MatthewLaverty/neon-digital-gauges/docs/neon-gauge-measurements.jpg

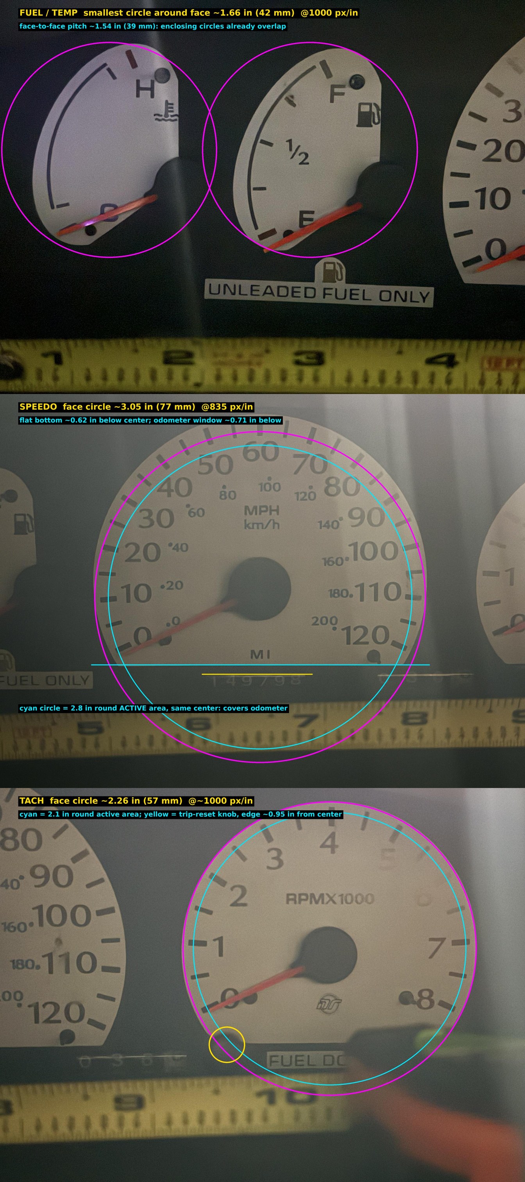
docs/neon-gauge-measurements.jpg
