MatthewLaverty/neon-digital-gauges/docs/frame/ref_frame_IMG_7629.jpg

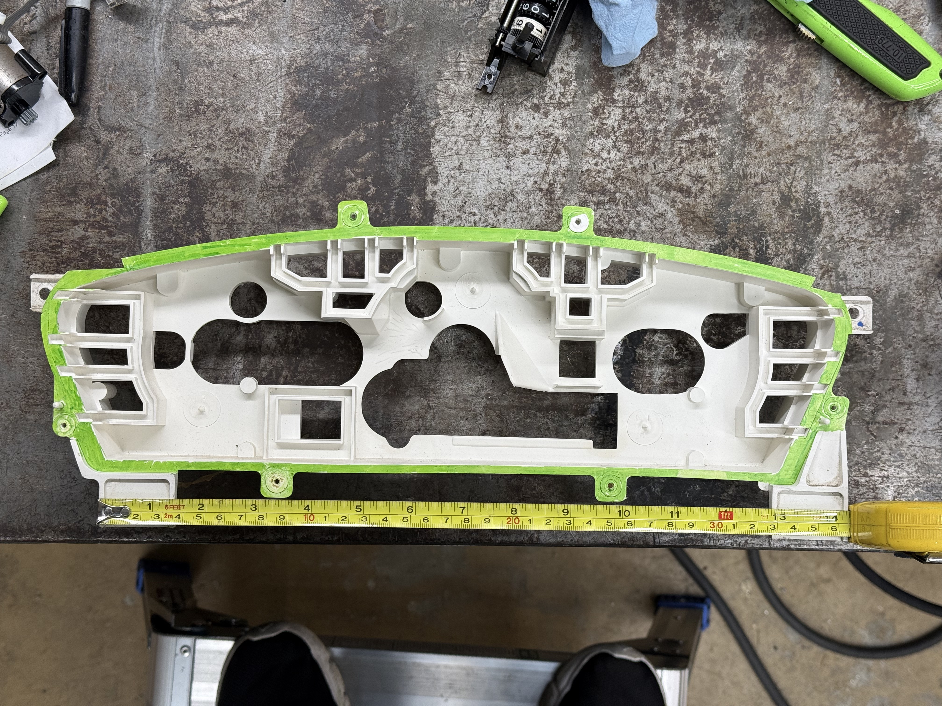
docs/frame/ref_frame_IMG_7629.jpg
