MatthewLaverty/neon-digital-gauges/docs/TOOLCHAIN.md

# Toolchain (pin these, update deliberately)
| Item | Version | Notes |
|---|---|---|
| Arduino IDE | record here | |
| esp32 Arduino core | match Waveshare demo | record exact version used by the demo you fork |
| LVGL | 8.3.10 | Waveshare examples target 8.3.10; do NOT use v9 with their BSP |
| Board settings | ESP32S3 Dev Module, PSRAM OPI, 16MB flash, USB CDC on boot | confirm per Waveshare wiki |
