MatthewLaverty/neon-digital-gauges/art/boost/boost_dial_A8_R240.png

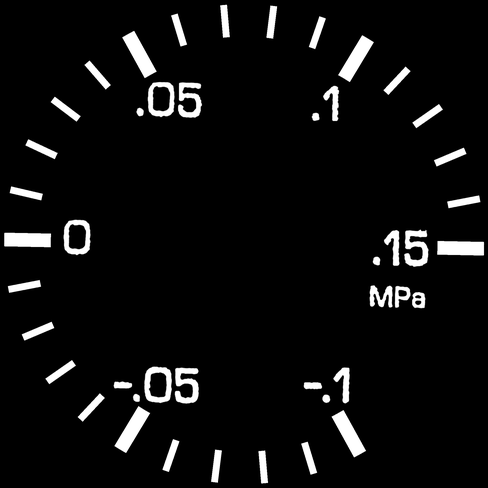
art/boost/boost_dial_A8_R240.png
