MatthewLaverty/neon-digital-gauges/art/boost/ref_IMG_7566.jpg

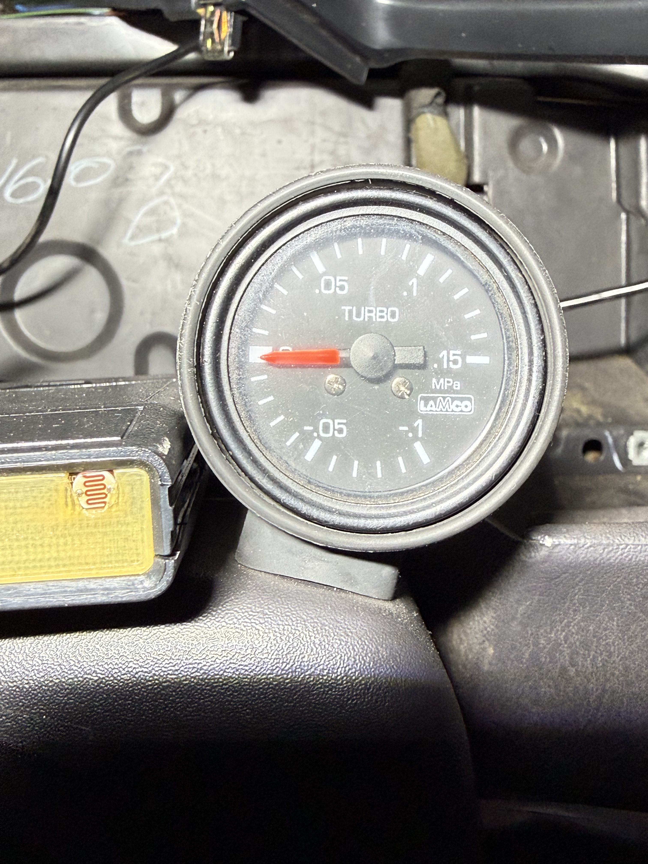
art/boost/ref_IMG_7566.jpg
