MatthewLaverty/neon-digital-gauges/art/faces/cluster_master_10pxmm.png

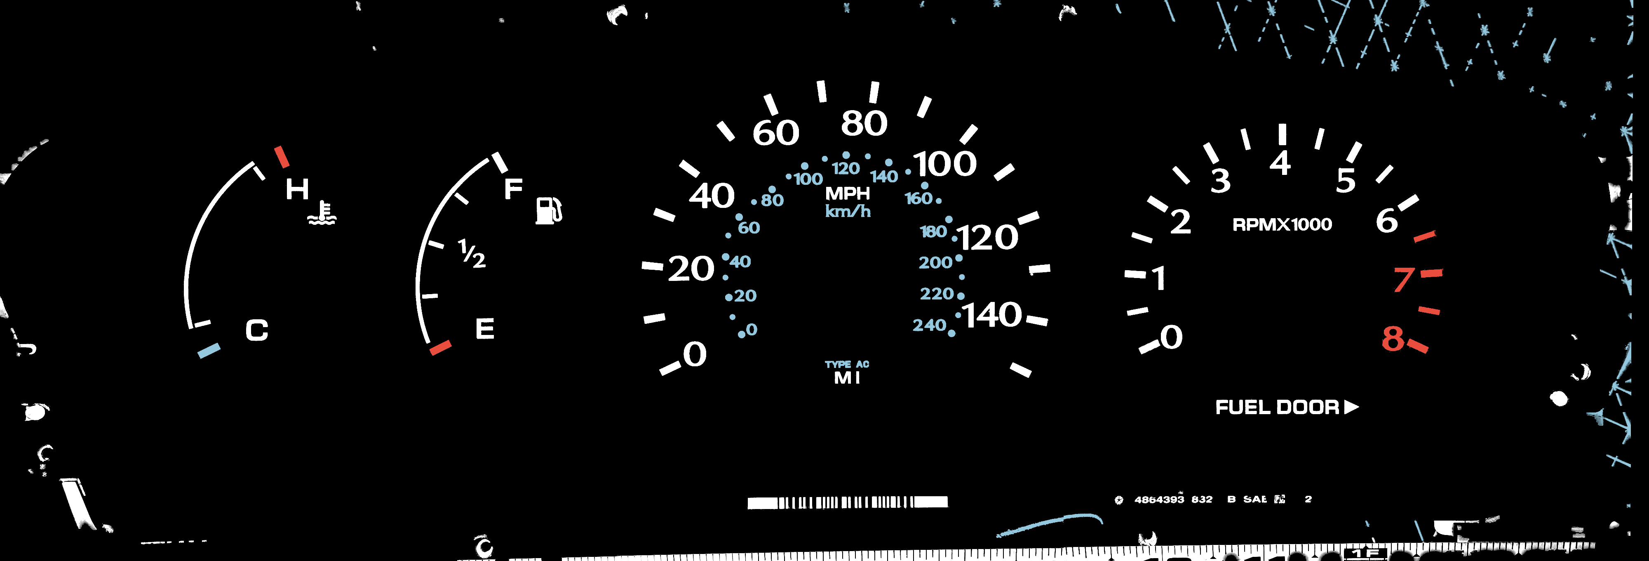
art/faces/cluster_master_10pxmm.png
