MatthewLaverty/neon-digital-gauges/art/faces/fuel_480.png

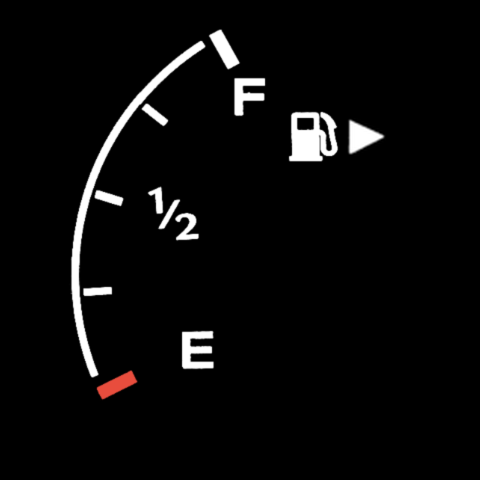
art/faces/fuel_480.png
