MatthewLaverty/neon-digital-gauges/art/faces/source/tach_480_with_fuel_door.png

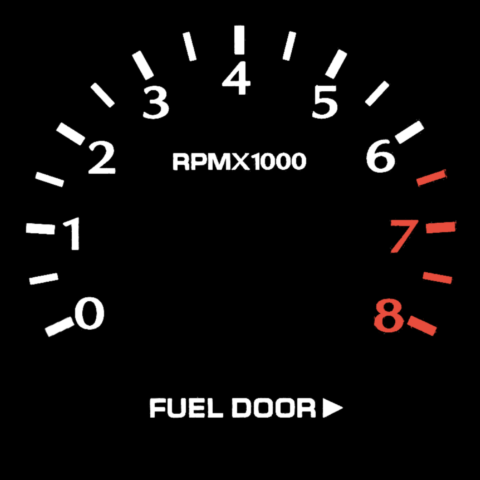
art/faces/source/tach_480_with_fuel_door.png
