MatthewLaverty/neon-digital-gauges/art/faces/speedo_480.png

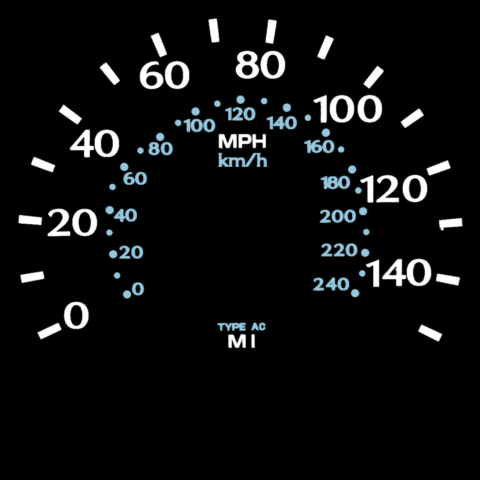
art/faces/speedo_480.png
