MatthewLaverty/neon-digital-gauges/art/glyphs/iso7000-2426_oil_temp_hires.png

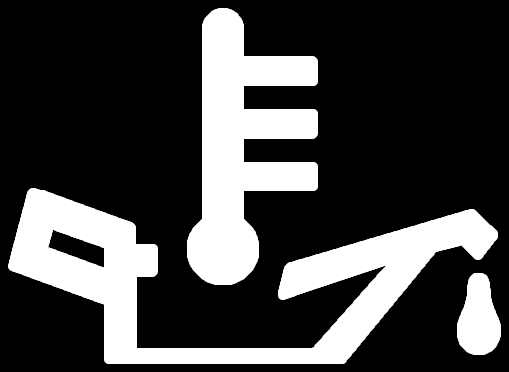
art/glyphs/iso7000-2426_oil_temp_hires.png
