MatthewLaverty/neon-digital-gauges/art/glyphs/seg7/ref_dakota_cluster.webp

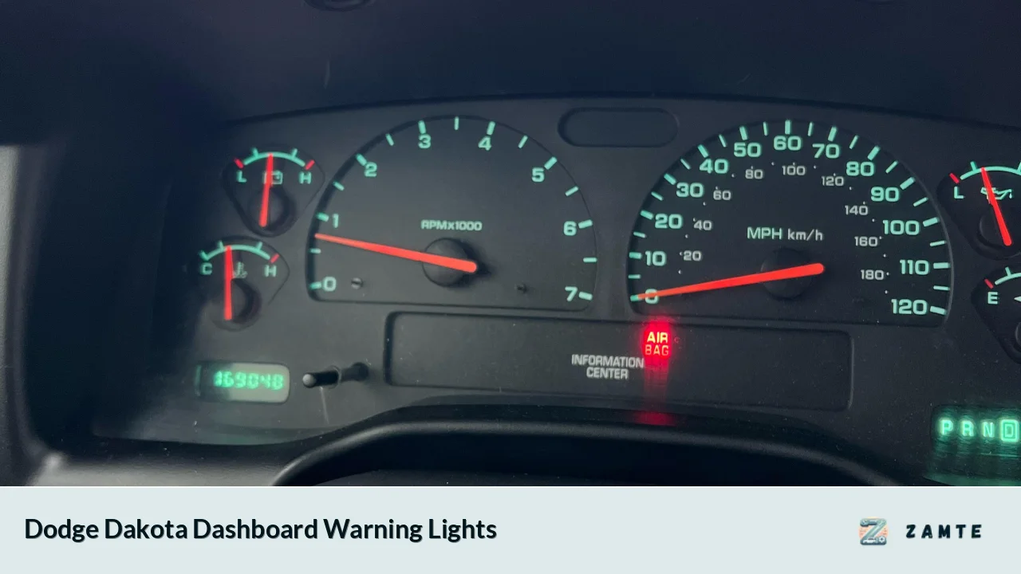
art/glyphs/seg7/ref_dakota_cluster.webp
