MatthewLaverty/neon-digital-gauges/art/glyphs/seg7/ref_toyota_odo.jpg

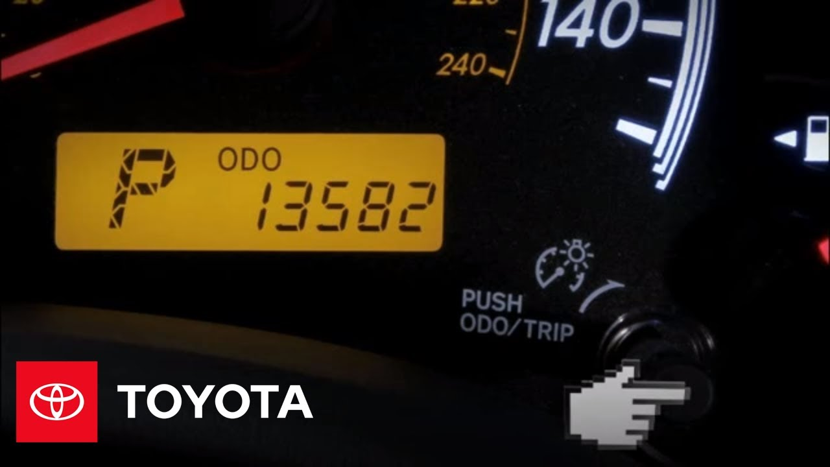
art/glyphs/seg7/ref_toyota_odo.jpg
