MatthewLaverty/neon-digital-gauges/art/glyphs/seg7/ref_toyota_ODO_trace.png

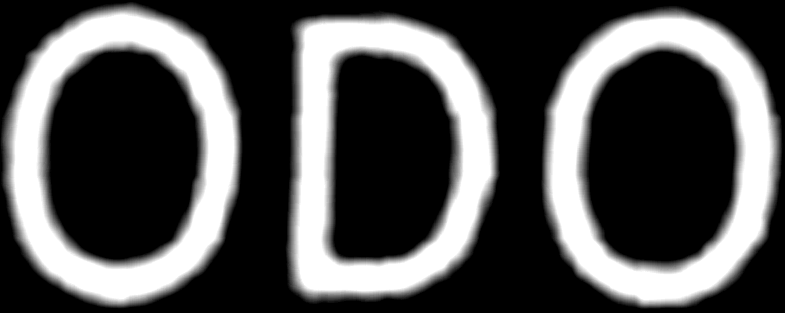
art/glyphs/seg7/ref_toyota_ODO_trace.png
