MatthewLaverty/neon-digital-gauges/art/glyphs/seg7/ref_toyota_trip.jpg

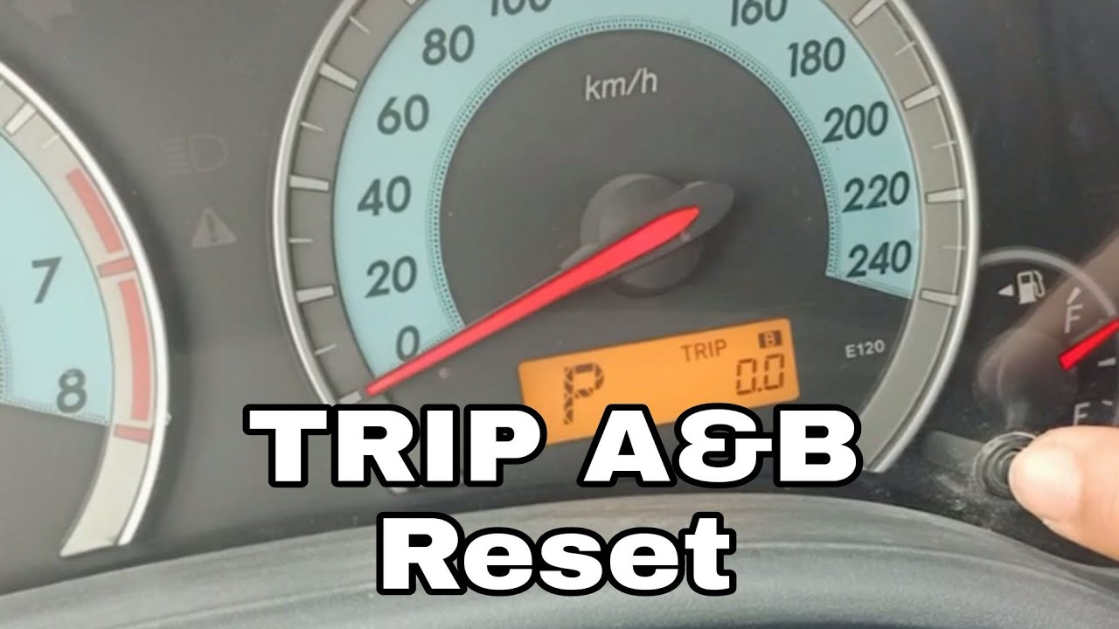
art/glyphs/seg7/ref_toyota_trip.jpg
