MatthewLaverty/neon-digital-gauges/art/preview/alert_flash_preview.png

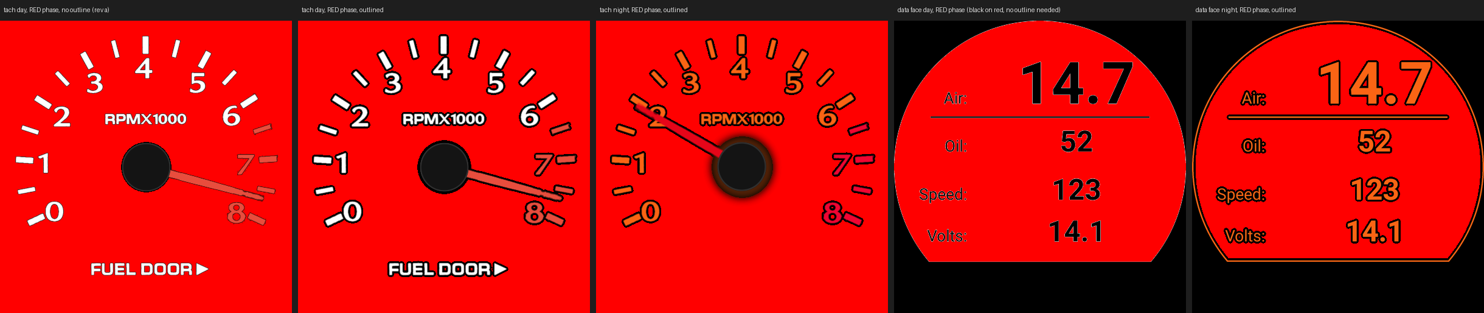
art/preview/alert_flash_preview.png
