MatthewLaverty/neon-digital-gauges/art/preview/all_holecheck.png

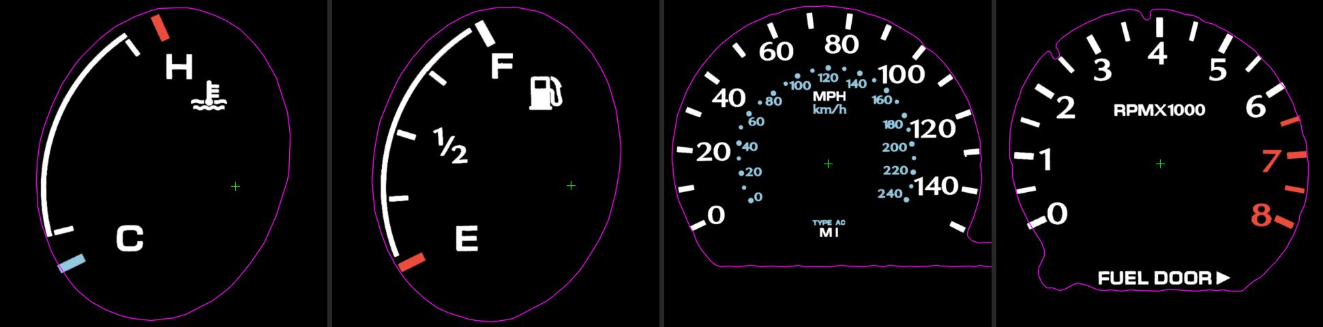
art/preview/all_holecheck.png
