MatthewLaverty/neon-digital-gauges/art/preview/all_with_needles.png

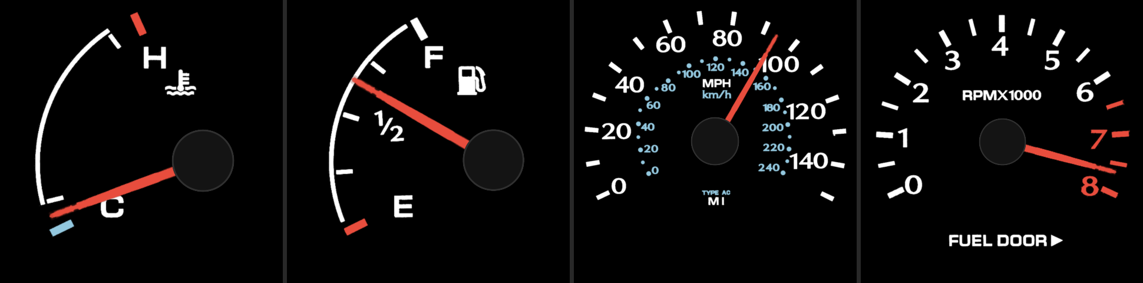
art/preview/all_with_needles.png
