MatthewLaverty/neon-digital-gauges/art/preview/cluster_mockup.png

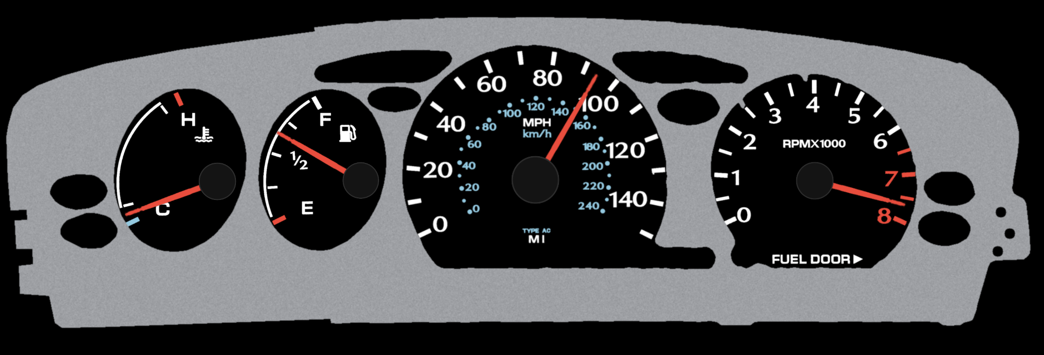
art/preview/cluster_mockup.png
