MatthewLaverty/neon-digital-gauges/art/preview/fuel_480_holecheck.png

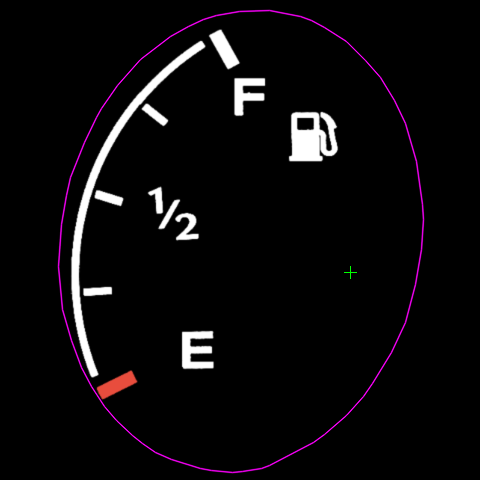
art/preview/fuel_480_holecheck.png
