MatthewLaverty/neon-digital-gauges/art/preview/fuel_480_night.png

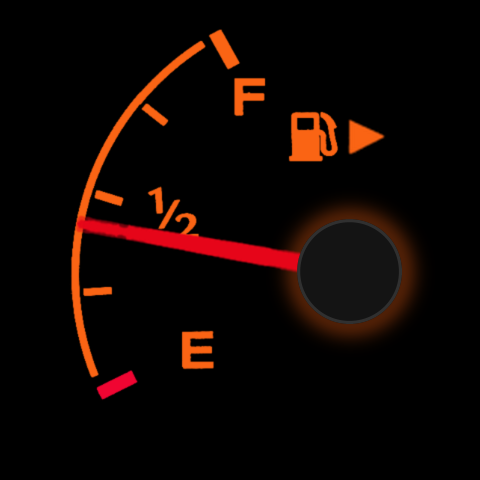
art/preview/fuel_480_night.png
