MatthewLaverty/neon-digital-gauges/art/preview/fuel_480_with_needle.png

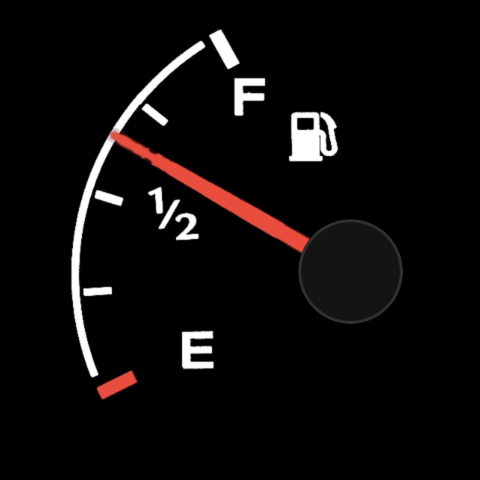
art/preview/fuel_480_with_needle.png
