MatthewLaverty/neon-digital-gauges/art/preview/fuel_cel_preview.png

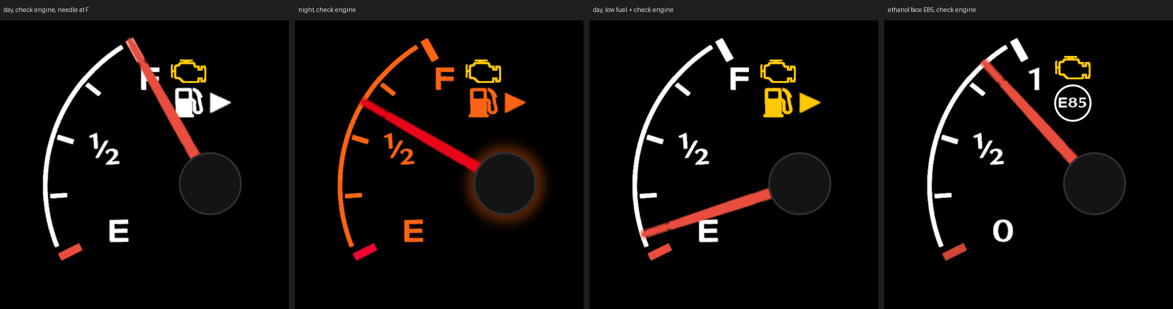
art/preview/fuel_cel_preview.png
