MatthewLaverty/neon-digital-gauges/art/preview/fuel_ethanol_preview.png

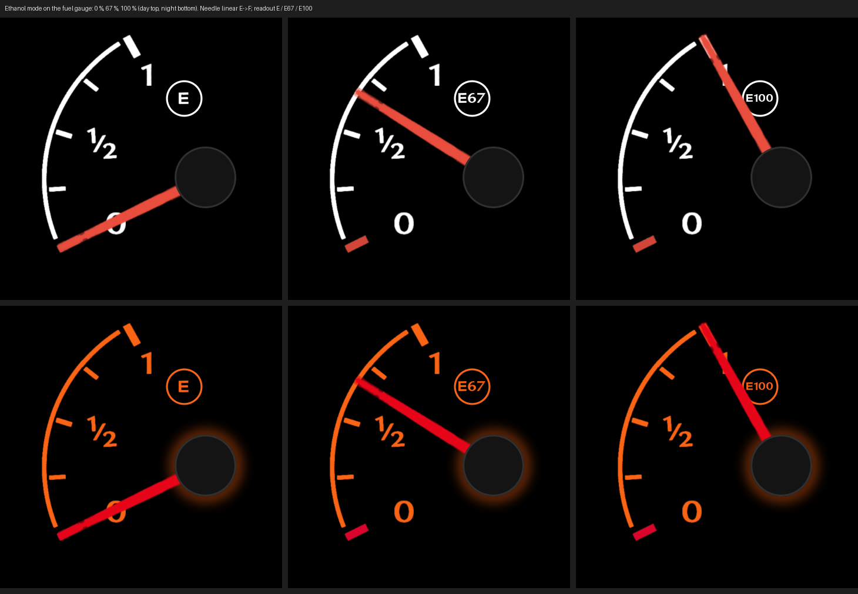
art/preview/fuel_ethanol_preview.png
