MatthewLaverty/neon-digital-gauges/art/preview/fuel_lowfuel_preview.png

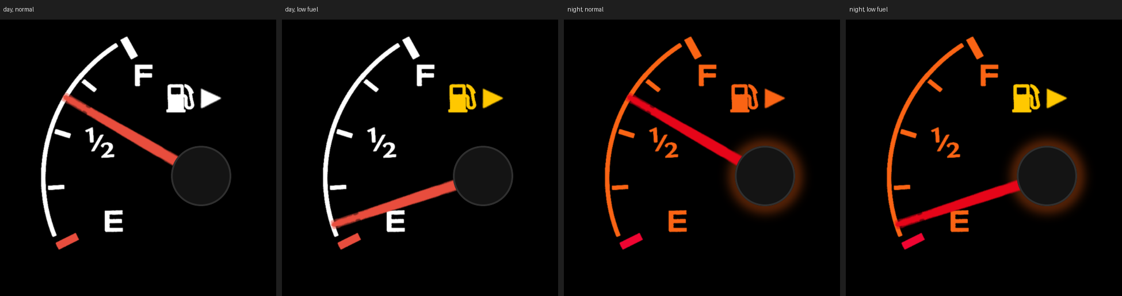
art/preview/fuel_lowfuel_preview.png
