MatthewLaverty/neon-digital-gauges/art/preview/knob_ui_preview.png

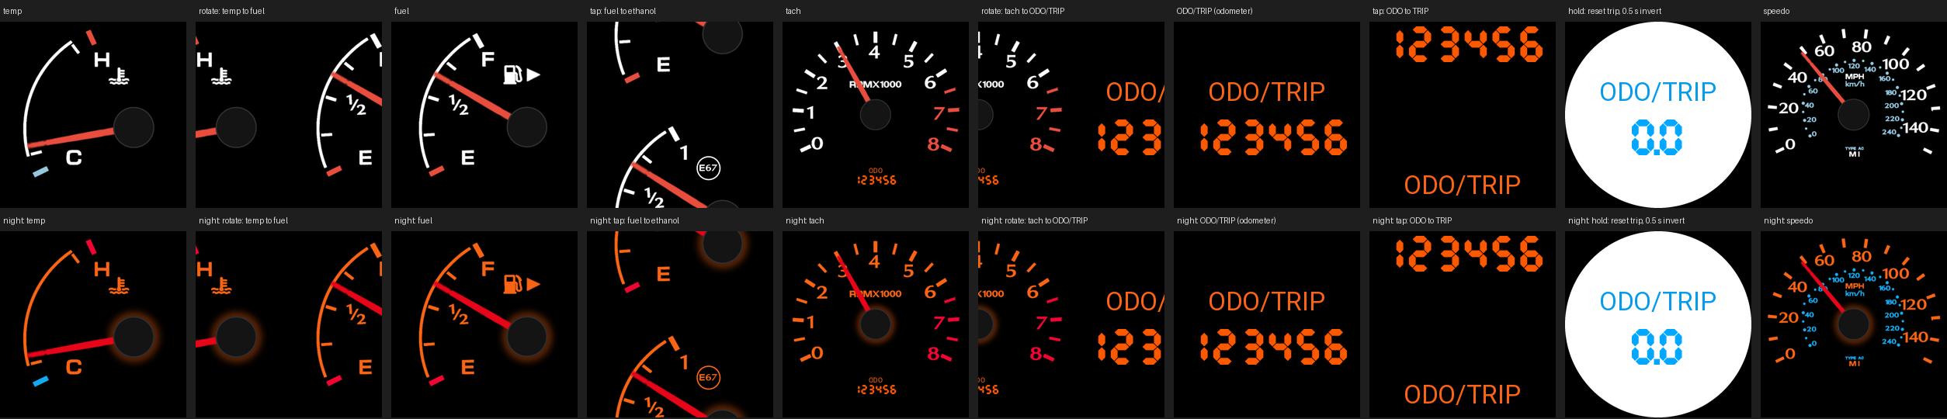
art/preview/knob_ui_preview.png
