MatthewLaverty/neon-digital-gauges/art/preview/night_mode_preview.png

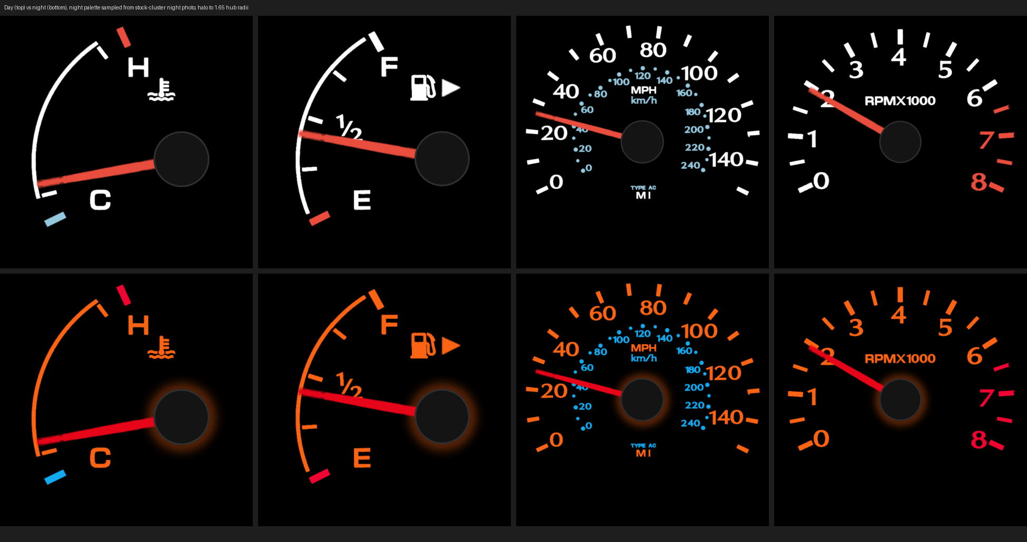
art/preview/night_mode_preview.png
