MatthewLaverty/neon-digital-gauges/art/preview/odo_trip_preview.png

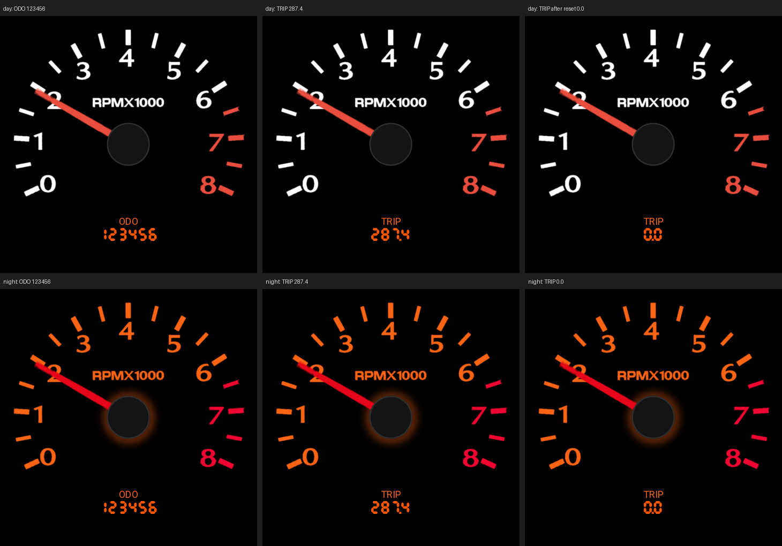
art/preview/odo_trip_preview.png
