MatthewLaverty/neon-digital-gauges/art/preview/odo_zoom.png

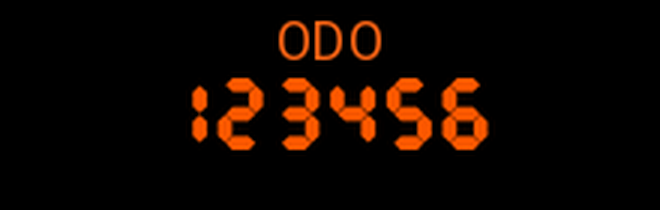
art/preview/odo_zoom.png
