MatthewLaverty/neon-digital-gauges/art/preview/speedo_480_holecheck.png

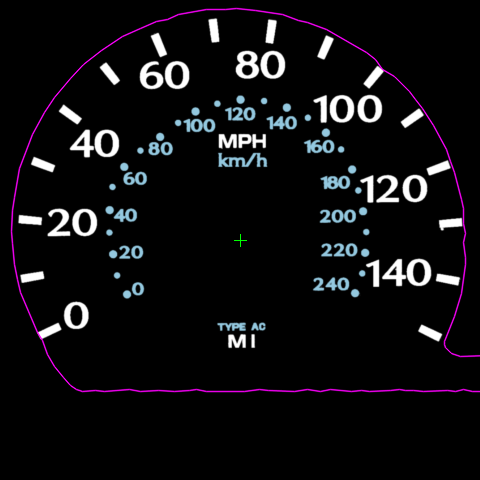
art/preview/speedo_480_holecheck.png
