MatthewLaverty/neon-digital-gauges/art/preview/speedo_480_night.png

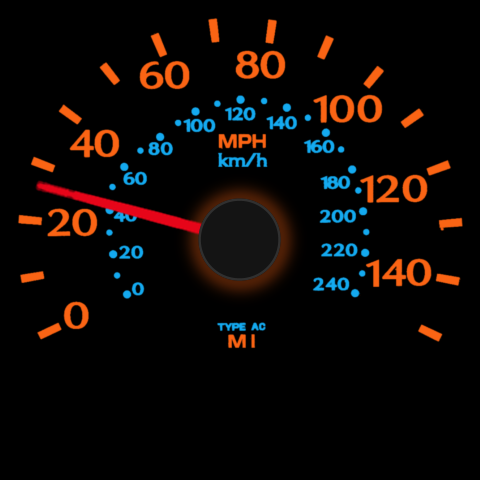
art/preview/speedo_480_night.png
