MatthewLaverty/neon-digital-gauges/art/preview/speedo_data_800_day.png

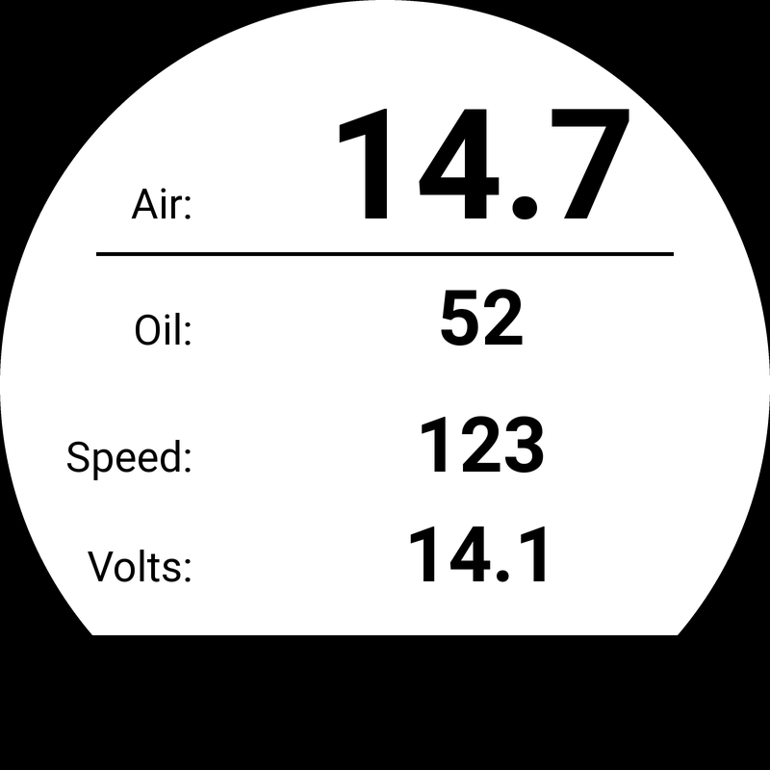
art/preview/speedo_data_800_day.png
