MatthewLaverty/neon-digital-gauges/art/preview/speedo_data_800_night.png

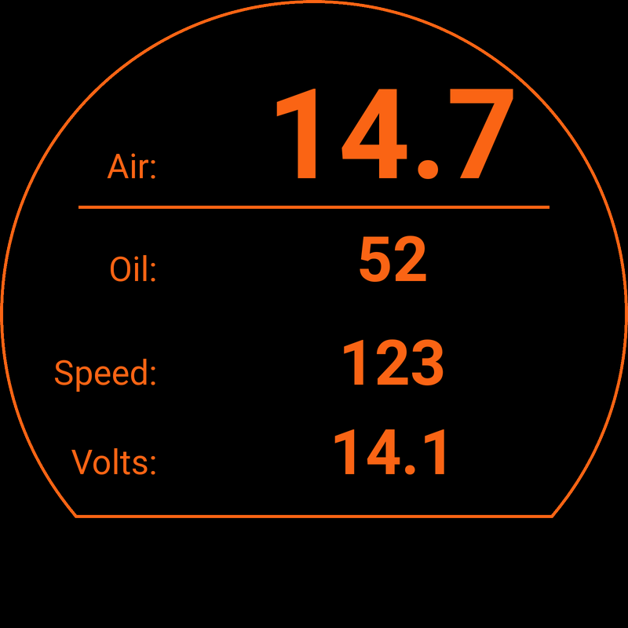
art/preview/speedo_data_800_night.png
