MatthewLaverty/neon-digital-gauges/art/preview/speedo_data_preview.png

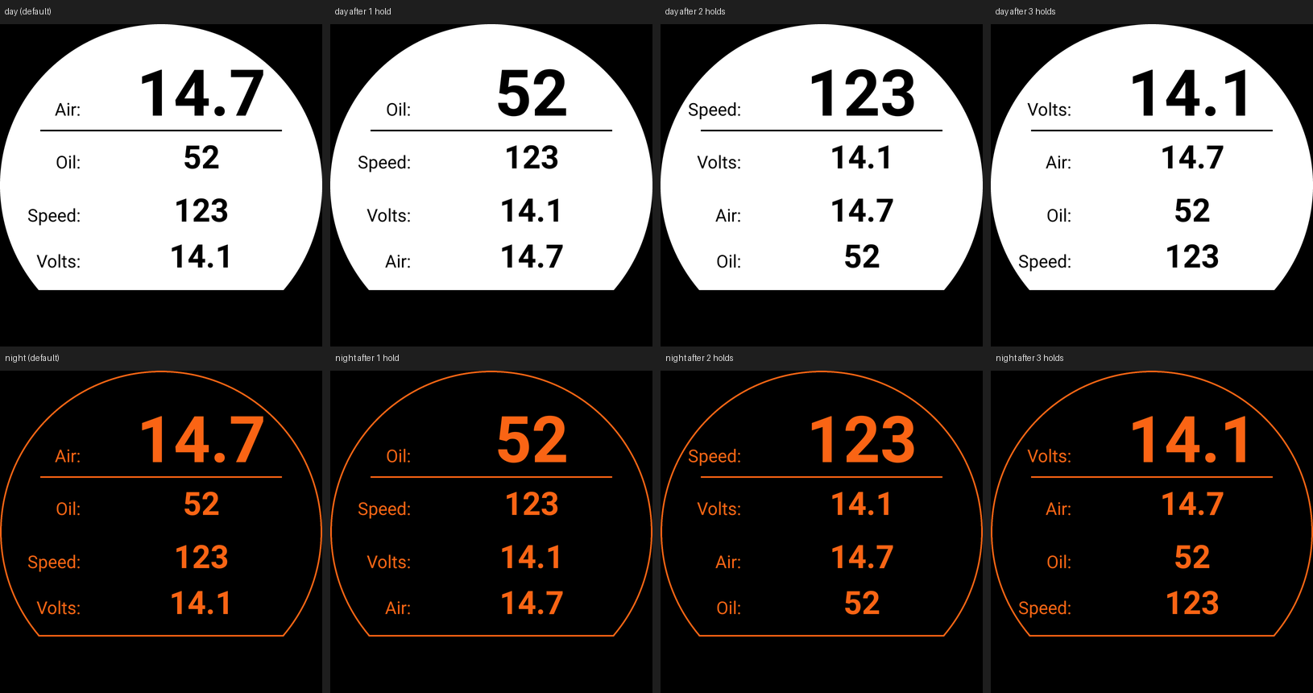
art/preview/speedo_data_preview.png
