MatthewLaverty/neon-digital-gauges/art/preview/tach_480_holecheck.png

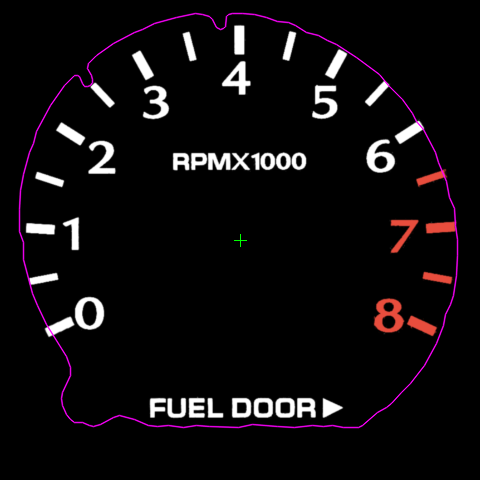
art/preview/tach_480_holecheck.png
