MatthewLaverty/neon-digital-gauges/art/preview/tach_480_night.png

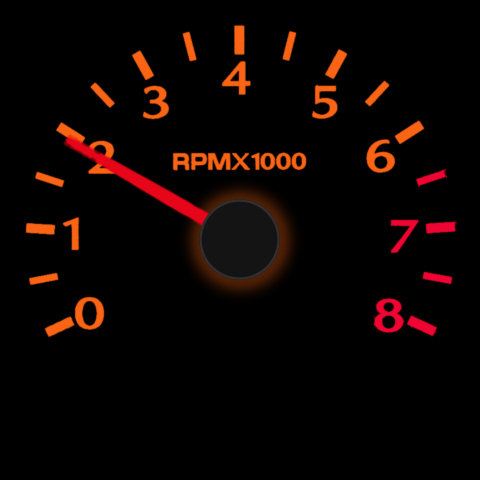
art/preview/tach_480_night.png
