MatthewLaverty/neon-digital-gauges/art/preview/tach_480_with_needle.png

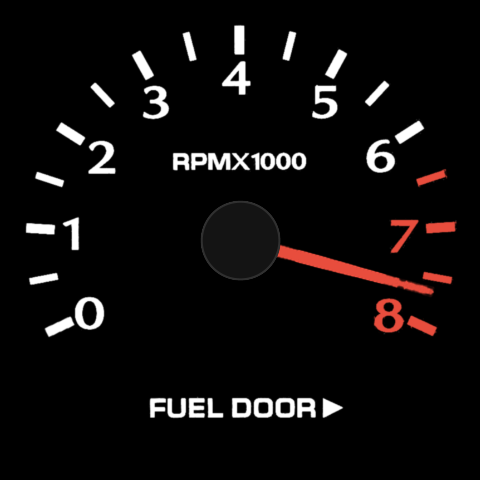
art/preview/tach_480_with_needle.png
