MatthewLaverty/neon-digital-gauges/art/preview/tach_boost_480.png

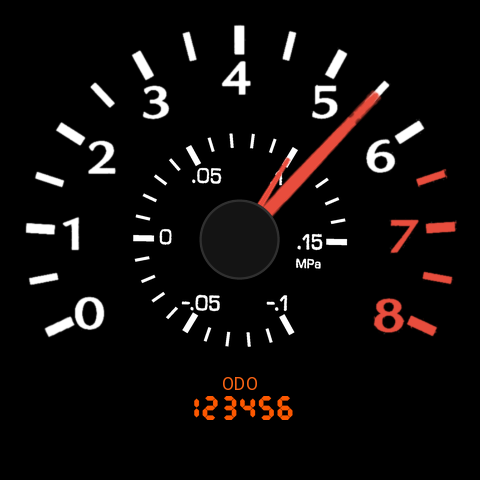
art/preview/tach_boost_480.png
