MatthewLaverty/neon-digital-gauges/art/preview/tach_boost_480_night.png

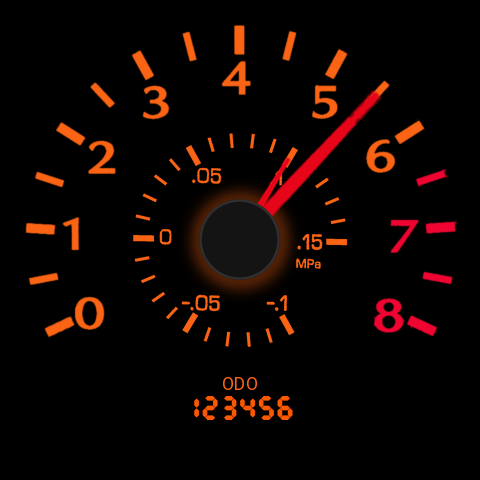
art/preview/tach_boost_480_night.png
