MatthewLaverty/neon-digital-gauges/art/preview/tach_boost_preview.png

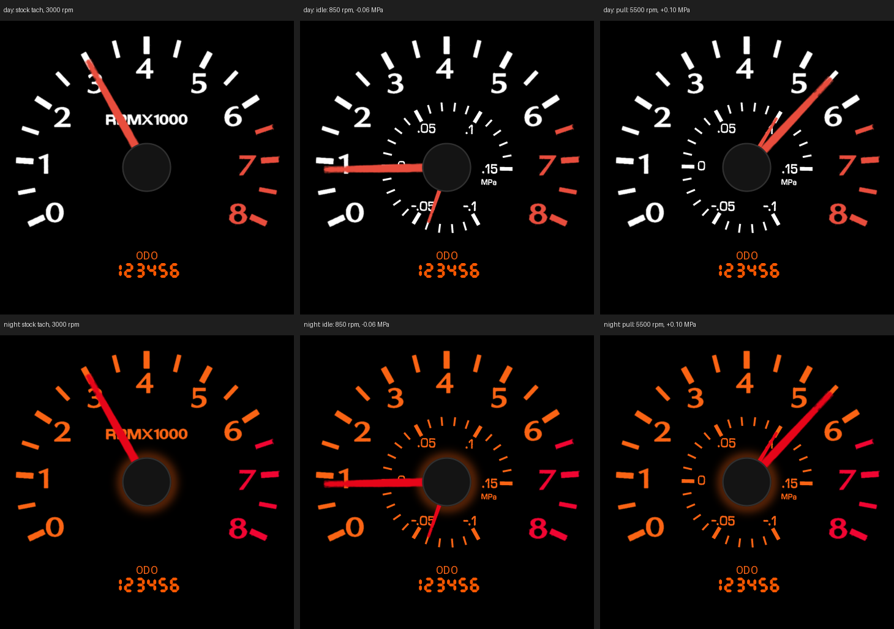
art/preview/tach_boost_preview.png
