MatthewLaverty/neon-digital-gauges/art/preview/temp_480_with_needle.png

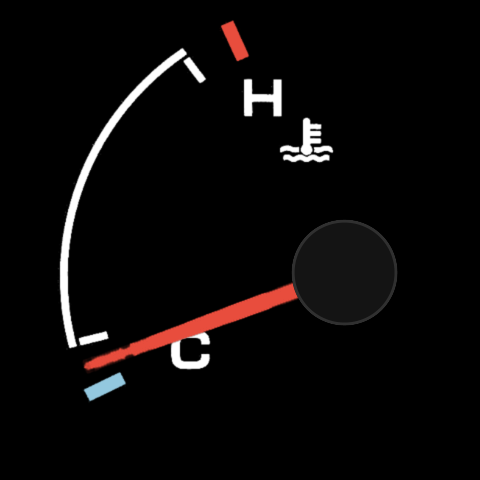
art/preview/temp_480_with_needle.png
