MatthewLaverty/neon-digital-gauges/art/preview/temp_oil_preview.png

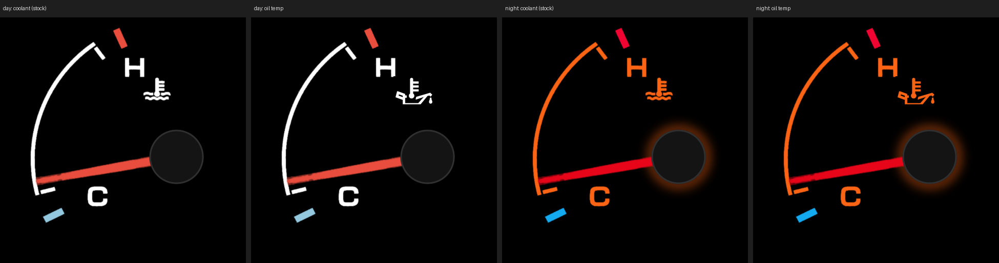
art/preview/temp_oil_preview.png
