MatthewLaverty/neon-digital-gauges/docs/bench/breadboard_car_io.png

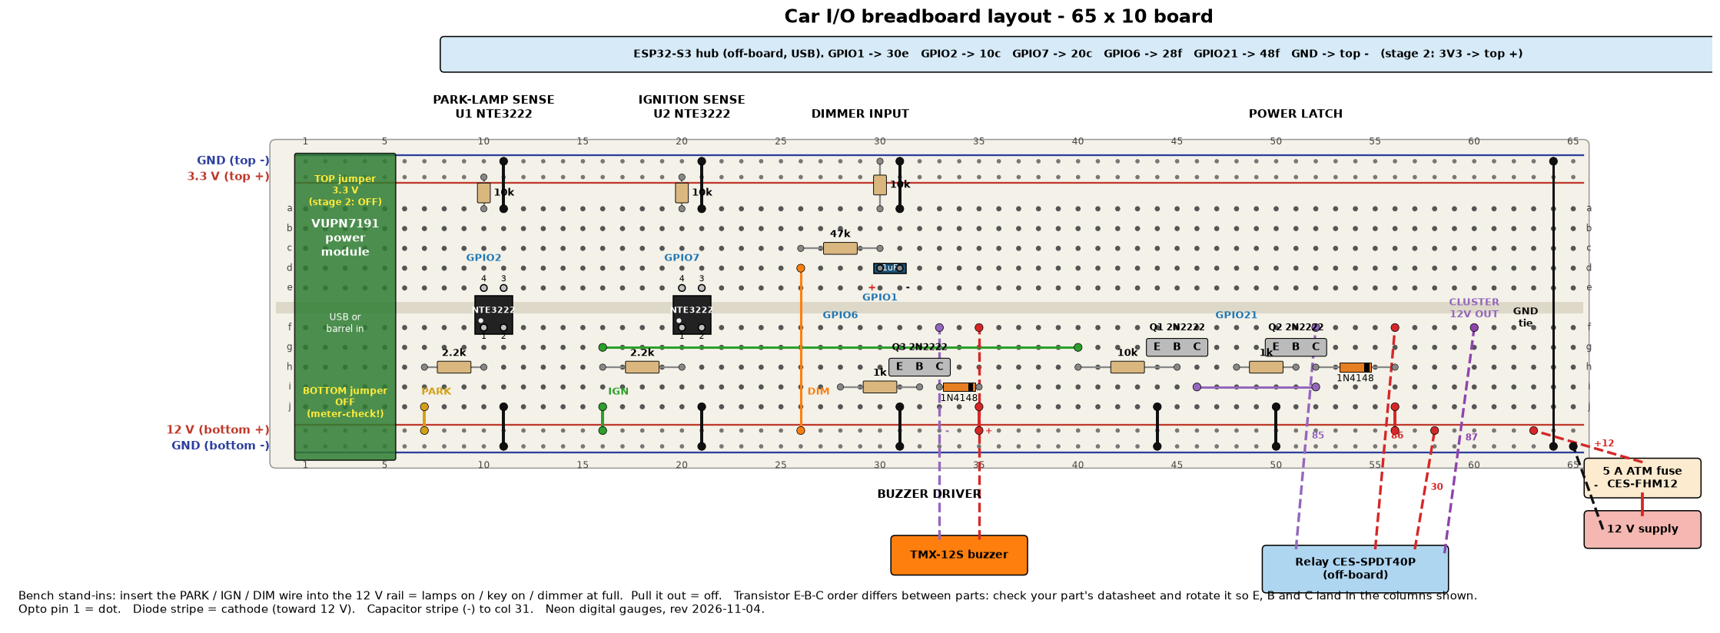
docs/bench/breadboard_car_io.png
