MatthewLaverty/neon-digital-gauges/docs/frame/frame_fit.png

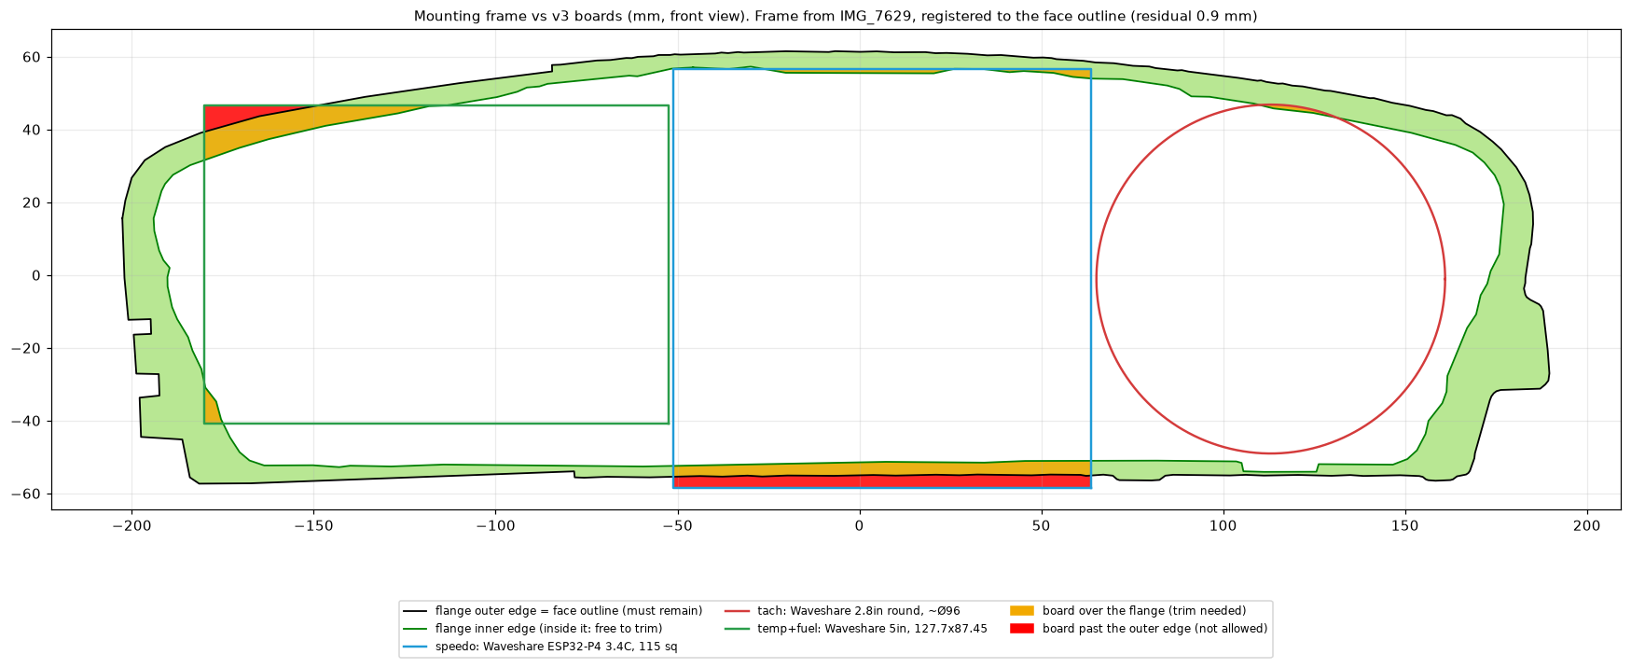
docs/frame/frame_fit.png
