MatthewLaverty/neon-digital-gauges/docs/frame/frame_trim.png

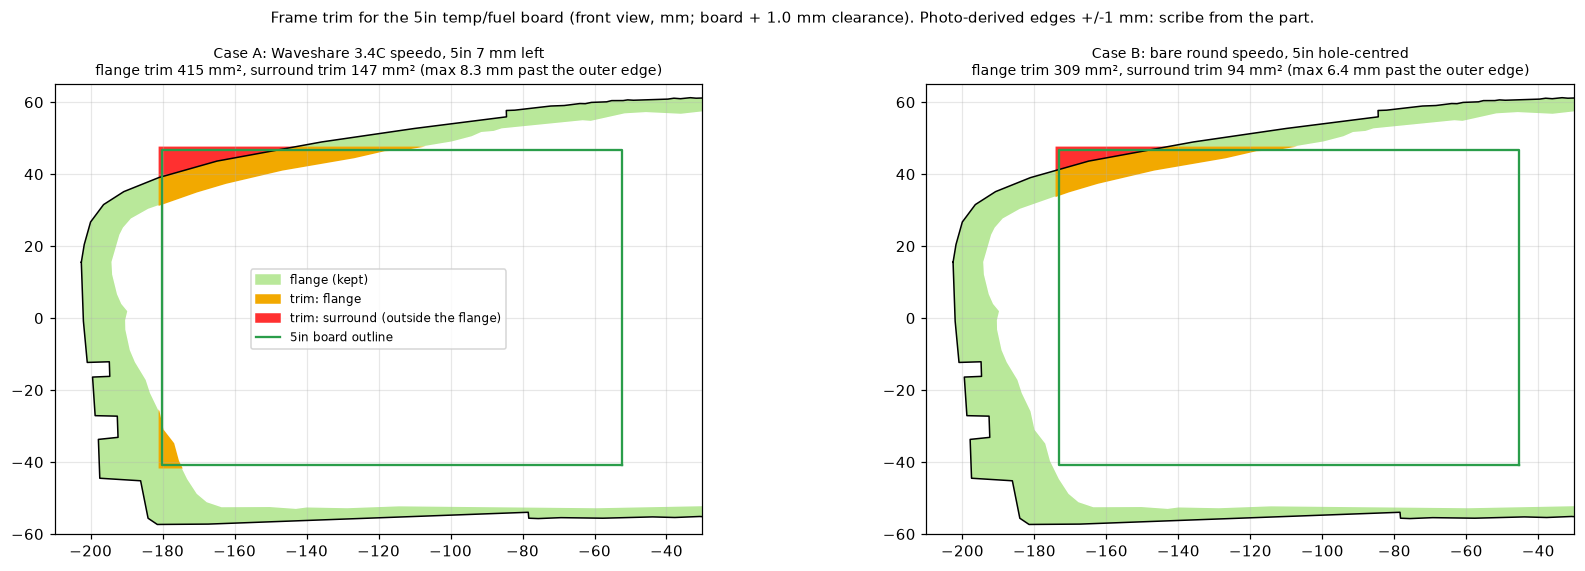
docs/frame/frame_trim.png
