MatthewLaverty/neon-digital-gauges/docs/layout/screen_layout.png

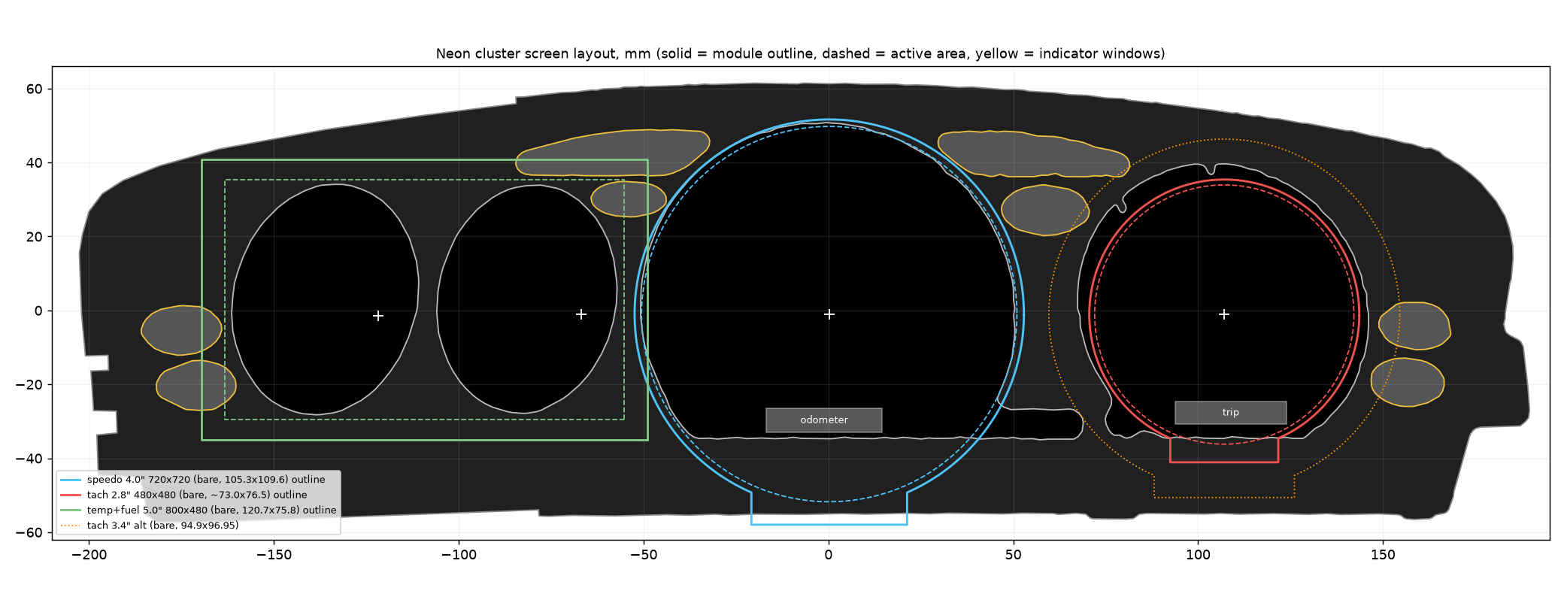
docs/layout/screen_layout.png
