MatthewLaverty/neon-digital-gauges/docs/layout/screen_layout_v2.png

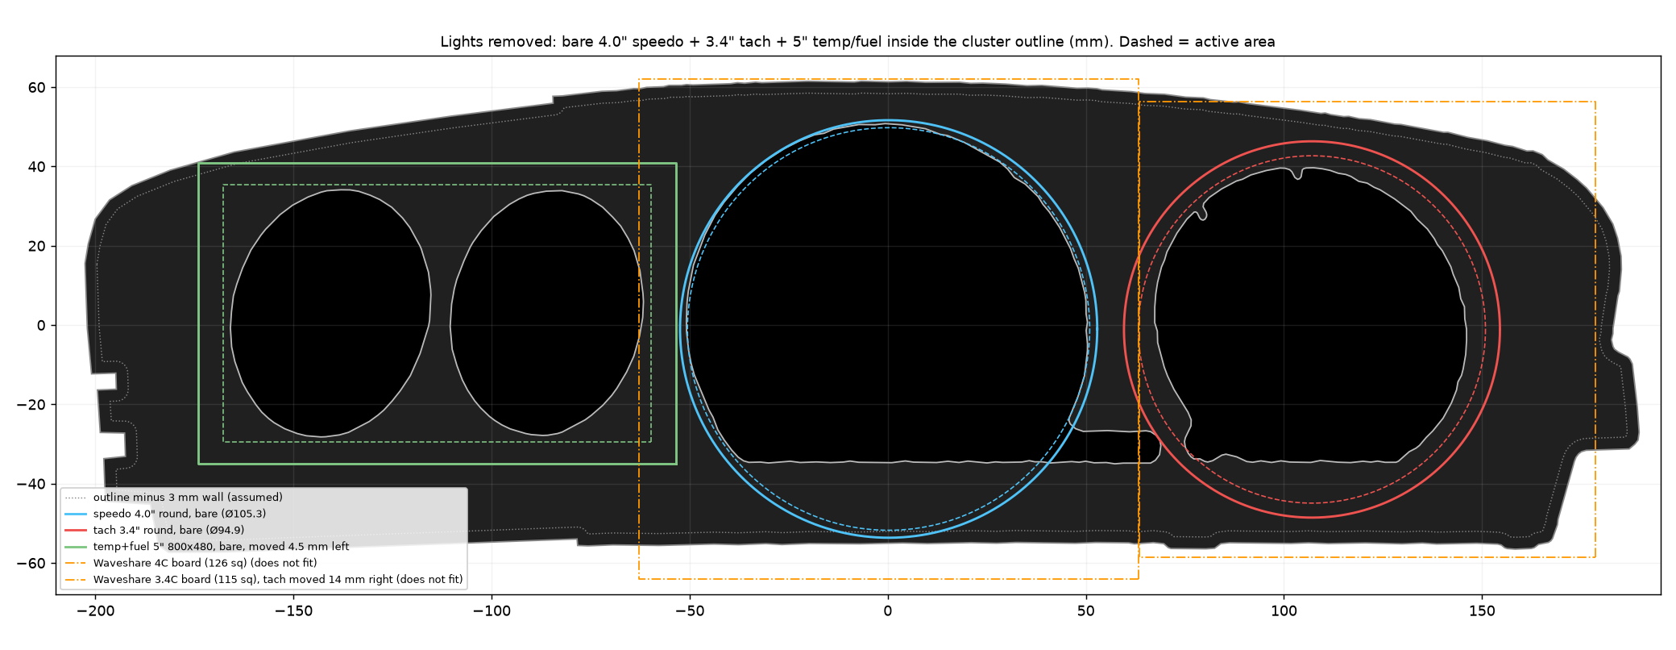
docs/layout/screen_layout_v2.png
