MatthewLaverty/neon-digital-gauges/docs/layout/screen_layout_v3.png

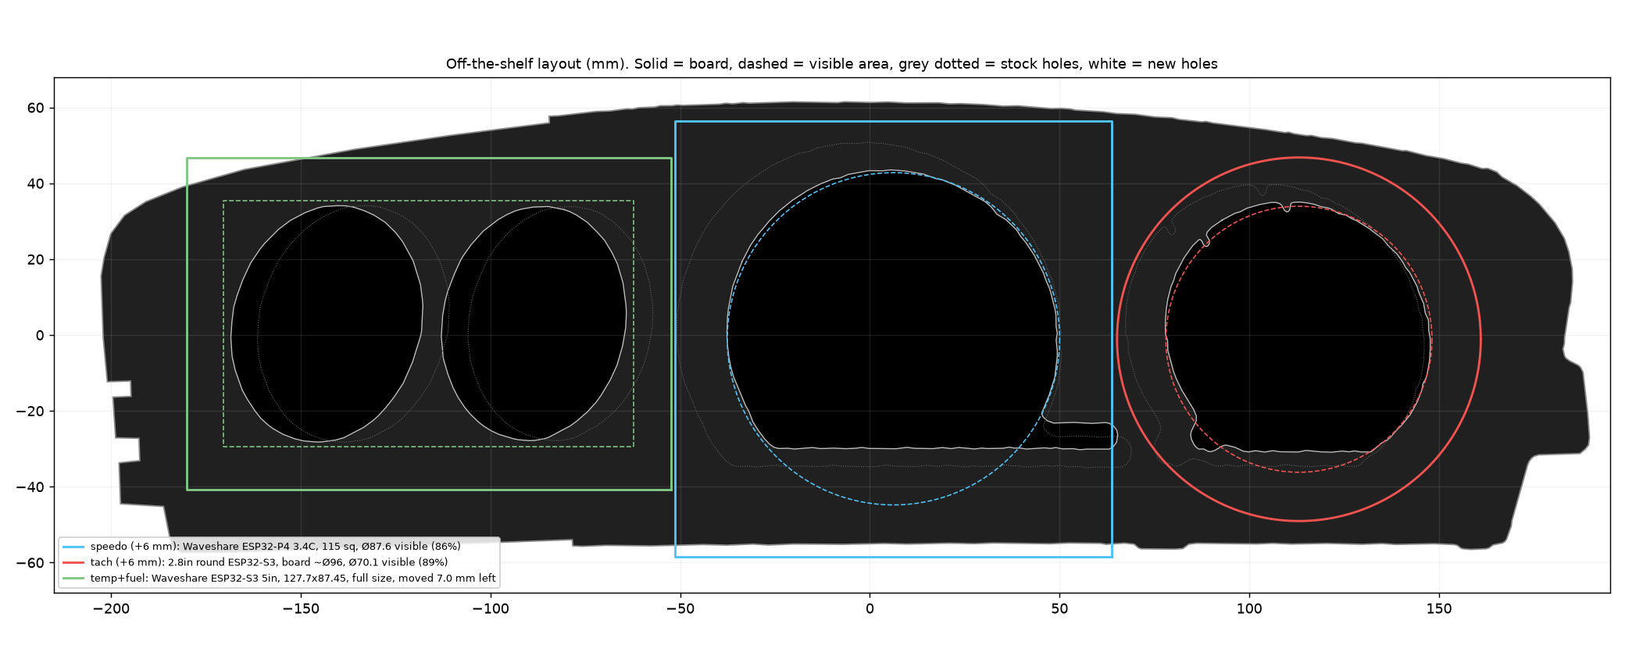
docs/layout/screen_layout_v3.png
