MatthewLaverty/neon-digital-gauges/docs/layout/screen_layout_v4.png

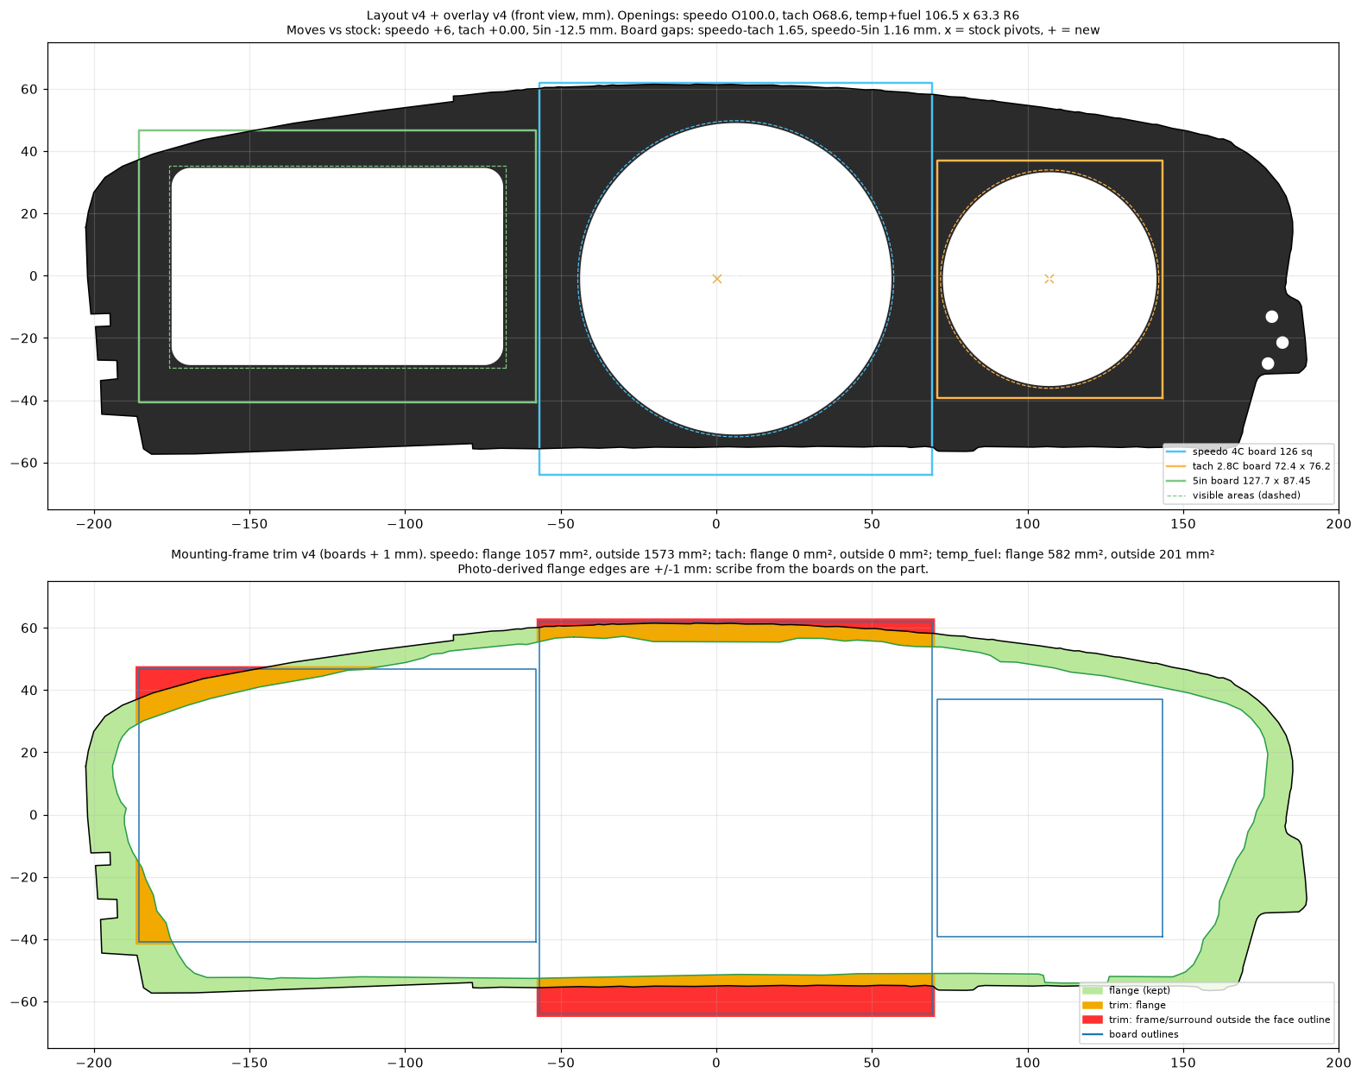
docs/layout/screen_layout_v4.png
