MatthewLaverty/neon-digital-gauges/firmware/tach-demo/startup.gif

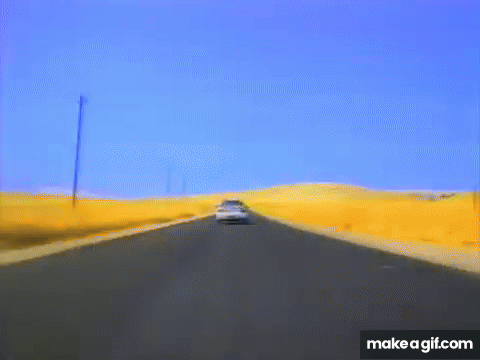
firmware/tach-demo/startup.gif
