MatthewLaverty/neon-digital-gauges/docs/frame/frame_trim_v4.dxf

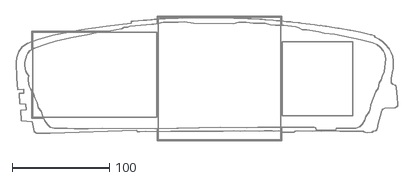
[picture p50: CAD file, 2026-10-27]
docs/frame/frame_trim_v4.dxf
392.3 x 128.0
