MatthewLaverty/neon-digital-gauges/hardware/overlay_v4/neon_overlay_v4.stl

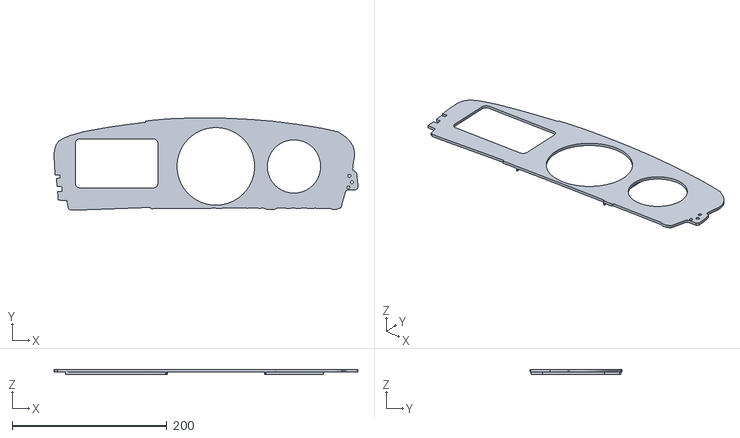
[picture p51: CAD file, 2026-10-27]
hardware/overlay_v4/neon_overlay_v4.stl
392.3 x 118.8 x 6.00
