MatthewLaverty/neon-digital-gauges/hardware/overlay/neon_overlay.stl

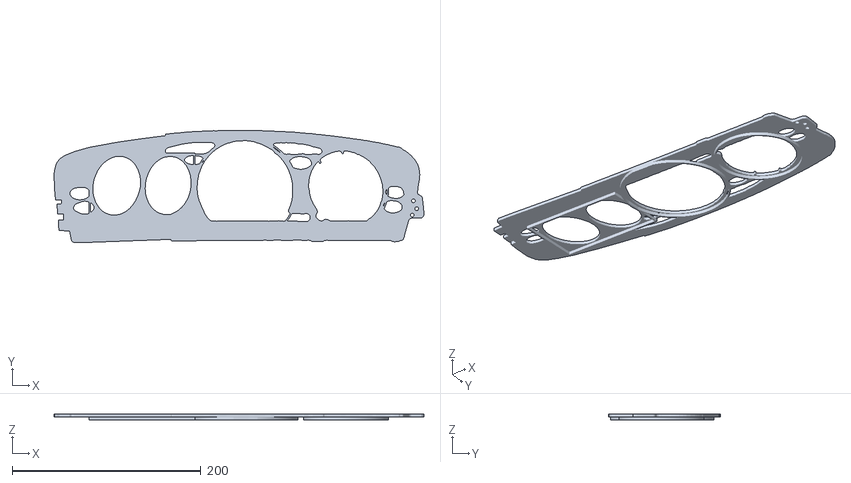
[picture p52: CAD file, 2026-10-19, an earlier design]
hardware/overlay/neon_overlay.stl
392.3 x 118.8 x 6.00
