MatthewLaverty/neon-digital-gauges/docs/frame/frame_trim.dxf

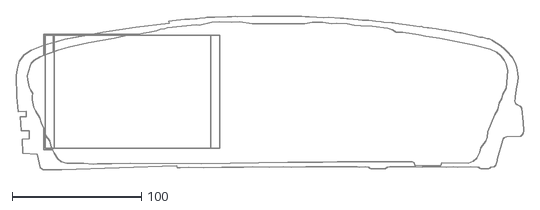
[picture p53: CAD file, 2026-10-19, an earlier design]
docs/frame/frame_trim.dxf
392.3 x 118.8
