MatthewLaverty/neon-digital-gauges/hardware/overlay/neon_overlay_outline.dxf

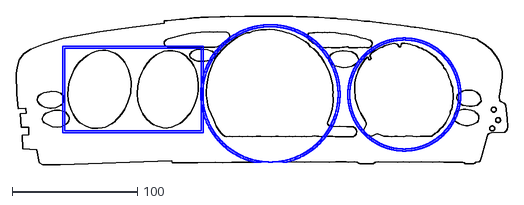
[picture p54: CAD file, 2026-10-19, an earlier design]
hardware/overlay/neon_overlay_outline.dxf
392.3 x 118.8
