MatthewLaverty/neon-digital-gauges/(list of files, cad)

Other CAD files:
hardware/overlay/overlay.scad
hardware/overlay_v4/neon_overlay_v4.dxf
