MatthewLaverty/neon-digital-gauges/docs/bench/POC-WIRING.md

# Bench PoC wiring (rev 2026-11-01: twist knob replaces the membrane keypad)

Diagram: `docs/bench/poc_wiring.png` (generated by `tools/bench/wiring_diagram.py`).

## Hub: ESP32-S3-DevKitC-1 N16R8

| GPIO | Function | Connects to |
|---|---|---|
| 4 | TWAI TX | CAN board #1 CTX |
| 5 | TWAI RX | CAN board #1 CRX |
| 3V3 / GND | power | CAN board #1, pot ends |
| 1 | ADC (dimmer) | bench: pot wiper, pot ends to 3V3 and GND. Car: headlamp-switch dimmer output via a 47k/10k divider (below) |
| 2 | input, active low (10 kohm pull-up to 3V3) | bench: switch to GND (closed = lights on). Car: PC817 optocoupler from the park-lamp feed (below) |
| 6 | LEDC PWM out (buzzer) | 1 kohm to the NPN base of the buzzer driver (below) |
| 7 | input, active low (10 kohm pull-up) | car: ignition sense, PC817 from the RUN/START feed (Power latch, below). Bench: free |
| 8–15 | free (membrane keypad removed 2026-11-01) | — |
| USB-C (native) | power + flashing | PC |

Avoid: GPIO0/3/45/46 (strapping), 19/20 (USB), 26–37 (flash/octal PSRAM on N16R8), 38/48 (RGB LED, depends on board revision).

## Knob: Elecrow CrowPanel 1.28" rotary (replaces the membrane keypad, owner 2026-11-01)

The knob joins the CAN bus mid-bus through **CAN board #3** (SN65HVD230, no 120R), wired to its 4-pin 1.25 mm I2C connector:

| Knob connector | Use | Connects to |
|---|---|---|
| 5V | supply out | 5 V to 3.3 V LDO input; the LDO's 3.3 V output feeds CAN board #3 3V3 (the connector carries 5 V, not 3.3 V) |
| IO38 (SDA) | TWAI TX | CAN board #3 CTX |
| IO39 (SCL) | TWAI RX | CAN board #3 CRX |
| GND | ground | CAN board #3 GND, LDO GND |

- **Verify first:** check the connector pinout with a meter before wiring. The order above isn't confirmed from Elecrow.
- **Bench power:** the knob runs from USB-C, which is also how it's programmed. In the car, a 12-to-5 V buck (1 A or more) feeds it.
- **What it sends:** knob events go out as 0x6A2 (tap or hold, plus the selected stop); the hub answers with 0x6A1 (`docs/CAN-MAP.md`). The UI is in `docs/BEHAVIOR.md`.
- **Bus order:** USB-CAN adapter (120R) -> CAN board #1 (hub) -> [Blink, deferred] -> CAN board #3 (knob) -> CAN board #2 (tach, 120R). Power off: about 60 ohm between H and L.

Former membrane keypad map (retired 2026-11-01, kept for reference): (owner 2026-10-16: everything on the membrane pad for now; the Blink is deferred): 1 = temp coolant/oil, 2 = fuel level/ethanol, 3 = speedo data face (tap toggles stock/data face, hold 2 s on the data face rotates the order up, a hold on the stock face does nothing; replaces the overlay idea), A = trip key (tap toggles ODO/TRIP, hold 2 s resets the trip only), B = tach rpm/boost. The rest are spare. Ribbon order R1..R4, C1..C4 is the common layout for these pads; confirm with a meter (press a key, find the row/col pair).

## Buzzer: Star Micronics TMX-12S (owner part, marked "TMX-12S 96D")

The TMX series is Star's magnetic transducer line ("low frequency driving type, high sound pressure", [Star Micronics](https://www.star-m.jp/eng/products/transduc/index.html)), so it is a coil, not a piezo disc. Star's spec list rates the TMX-12 versions at 12 to 14 V and about 1,000 Hz ([Star-Asia product list](https://www.starasia.com/Download/Manual/Buzzer/productlist_by_spec_e.pdf)); a TMX-12SC listing gives 1 kHz, 85 dB at 14 V ([datasheets.com](https://www.datasheets.com/star-micronics)). The exact TMX-12S sheet was not found, and "96D" is probably a date code (inference).

| From | To |
|---|---|
| Hub GPIO6 | 1 kohm resistor -> NPN base (2N2222 or S8050) |
| NPN emitter | GND (hub GND = bus GND = bench supply GND) |
| NPN collector | buzzer (-) |
| buzzer (+) | +12 V bench supply |
| 1N4148 diode | across the buzzer, stripe (cathode) to +12 V; it catches the coil's turn-off spike |

Before wiring: measure the coil with a meter (expect tens to a few hundred ohm; current = 12 V / R must stay under about 300 mA for a 2N2222,; small 12 V magnetic buzzers typically draw tens of mA, but measure rather than assume). Owner bench result (2026-10-18): it clicks on 12 V DC, so it has no internal oscillator and needs a tone; `BUZZER_SELF_DRIVE` stays false. Sweep `BUZZER_FREQ_HZ` 800-3000 Hz and keep the loudest. Volume: `BUZZER_VOLUME_PCT` 100 = 50 % square-wave duty, the loudest a coil can be driven at a fixed voltage. Settings: `firmware/hub/alerts_config.h`.

## Tach: Waveshare ESP32-S3-LCD-2.8C

| Pin | Connects to |
|---|---|
| GPIO43 (UART TXD on the SH1.0 header) | CAN board #2 CTX |
| GPIO44 (UART RXD) | CAN board #2 CRX |
| 3V3 / GND | CAN board #2 |
| USB-C (native) | PC, power + flashing (the UART USB port shares GPIO43/44 and can't be used) |

Confirm the header pin order against the Waveshare silkscreen/wiki before connecting.

## Blink PKP-2300-SI (AT04-4P on the keypad, AT06-4S plug)

| Pin | Wire | Signal |
|---|---|---|
| 1 | blue | CAN L |
| 2 | white | CAN H |
| 3 | black | GND (battery -), also tied to bench/bus GND |
| 4 | red | +12–24 V |

Pinout and defaults are from the PKP-2200-SI CANopen manual (https://blinkmarine.com/app/uploads/2024/11/PKP_2200_SI_CANopen_UM.pdf). Same product family; confirm against the PKP-2300-SI documentation. Defaults: 125 kbit/s, node 15h, key-state PDO 195h, LED command 215h. Set 1 Mbit/s (object 2010h) on the adapter alone before joining the 1 Mbit/s bench bus.

## Park-lamp sense (car; night mode)

The park-lamp feed is 12-14.5 V with spikes, so it never goes straight to a hub pin (3.3 V max). An optocoupler isolates it:

| From | To |
|---|---|
| Park-lamp feed (12 V with park or headlamps on; must NOT change with the dash dimmer) | 2.2 kohm resistor -> PC817 pin 1 (anode) |
| PC817 pin 2 (cathode) | chassis ground |
| 1N4148 diode | across pins 1-2, stripe (cathode) to pin 1 (reverse-voltage protection) |
| PC817 pin 4 (collector) | hub GPIO2, plus 10 kohm to hub 3V3 |
| PC817 pin 3 (emitter) | hub GND |

About 5.7 mA through the LED at 13.8 V. Lamps on = GPIO2 LOW. The hub debounces it for 300 ms (`firmware/hub/park_lamp.h`) and sets 0x6A1 byte 2 bit 0, which every screen and the knob follow. On the bench, the existing switch to GND does the same job.

Finding the wire: with a meter, find a wire that reads battery voltage with the park lamps on and 0 V with them off, then turn the dash dimmer through its range: the voltage must not change. A feed that changes with the dimmer is the panel-lamp circuit, and it can drop below the optocoupler threshold at low dimmer settings. Confirm the wire colour against the 1999 Neon factory wiring diagram before tapping it (not verified here).

## Dash dimmer (car; night brightness)

The dimmer output lives in the headlamp switch with the park lamps (owner; wire colour not yet known). The hub reads it on GPIO1:

| From | To |
|---|---|
| Dimmer output | 47 kohm -> hub GPIO1 |
| Hub GPIO1 | 10 kohm to hub GND, and 1 uF capacitor to hub GND |

14.5 V gives 2.54 V at the pin; the 47 kohm limits spike current to under 1 mA. The cap and the firmware smoothing (`firmware/hub/dimmer.h`) average a PWM dimmer as well as a variable-voltage one. Brightness only follows the dimmer at night (park lamps on); by day the screens run at full brightness.

Measure before wiring (stock cluster still connected, park lamps on, engine running):
1. Back-probe the candidate wire. Turn the dimmer from low to high. A wire whose DC voltage changes with the dimmer is the one.
2. Note the voltage at the lowest and highest settings, and the battery voltage. These set `DIM_RATIO_MIN` / `DIM_RATIO_MAX` (dimmer V / battery V) in `dimmer.h`.
3. If the meter has a Hz or duty setting, check the wire: a reading means it is PWM (still fine; note the frequency).
4. Unplug the stock cluster and repeat step 1. If the voltage no longer changes (it sits near battery voltage), the switch is a series rheostat that needs a load to work. Add a dummy load from the dimmer output to ground (a 194 bulb or a 100 ohm 5 W resistor) and recalibrate. The 47 kohm divider alone is far too light a load to make a rheostat drop voltage.

## Power latch (car; PROPOSED 2026-10-22 for the 1 s shutdown fade)

The cluster runs from constant battery through a relay, so it can stay up for about 1.5 s after key-off to fade the screens and save state.

| From | To |
|---|---|
| Constant battery (fused, 5 A) | Relay pin 30, and relay coil pin 86 |
| Relay pin 87 | Cluster 12 V input (the 12 V to 5 V converters) |
| Relay coil pin 85 | Collectors of two NPN transistors (2N2222), emitters to ground; 1N4148 across the coil (stripe to 86) |
| Ignition RUN/START feed | 10 kohm -> NPN #1 base (key on = relay on) |
| Hub GPIO21 ("hold") | 1 kohm -> NPN #2 base (hub keeps the relay on after key-off) |
| Ignition RUN/START feed | 2.2 kohm -> PC817 #2 -> hub GPIO7 (same circuit as the park-lamp sense) |

At key-off, GPIO7 goes high. The hub sends the shutdown fade, saves state, waits `shutdown_hold_ms`, then drops GPIO21 and the relay opens. The draw is zero when off. Use the RUN/START feed, not ACC, because ACC drops out while cranking. GPIO21 is not in the bench pin list, so confirm it is free on the N16R8 board before wiring.

## CAN bus

USB-CAN adapter (120R switch ON) -> CAN board #1 (hub, no termination) -> Blink keypad (no termination) -> CAN board #2 (tach, 120R). Power off: about 60 ohm between H and L. If a mid-bus CAN board has a fixed 120R, remove it. Twist H with L and keep stubs short; tie all grounds together (adapter GND, both ESP32s via USB, 12 V supply negative).
