MatthewLaverty/neon-digital-gauges/docs/bench/poc_wiring.png

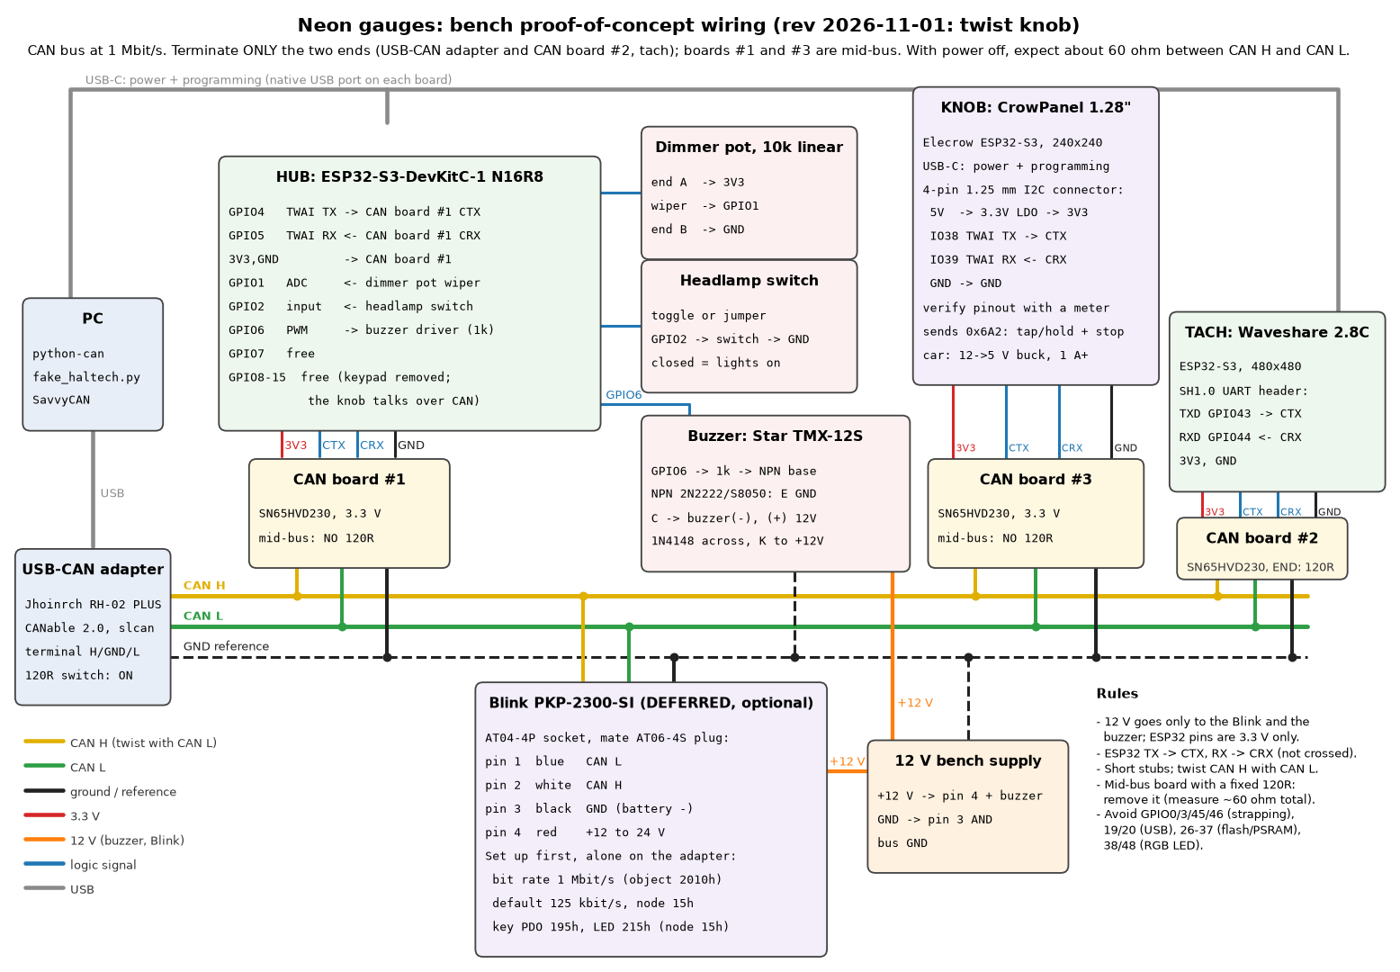
docs/bench/poc_wiring.png
