MatthewLaverty/neon-digital-gauges/(commit log)

2026-10-14 Initial import: plan, CAN map, BOM, firmware stub, temporary photo-derived faces/needles, parametric overlay
    [BOM.csv, neon_overlay.stl, neon_overlay_outline.dxf, overlay.scad]
2026-10-15 v2 faces, needles and overlay: rectified from needle-free photos; updated color rules (tach 7/8 red, temp H tick red, C tick blue, fuel E tick red)
    [neon_overlay.stl, neon_overlay_outline.dxf, overlay.scad]
2026-10-15 Level the frame (2.17 deg CCW from text baselines), rebuild tach 0 tick, fix the stop-pin mask clipping the tach 8
    [neon_overlay.stl, neon_overlay_outline.dxf, overlay.scad]
2026-10-15 Layout v2: lights removed, full-size 3.4in tach, temp/fuel shifted 4.5 mm
2026-10-15 Layout v3: off-the-shelf boards, 3.4C speedo at 86%, housing trim allowed
2026-10-15 Decision: night mode recolors white printing orange via A8 mask layer
2026-10-15 Night mode: needle-orange printing, hub halo, preview
2026-10-15 Oil-temp alternate face (ISO 7000-2426); keypad control proposal; BOM option
2026-10-15 PoC BOM: keypad and AT06-4S mating kit in the main list
2026-10-16 Bench PoC wiring diagram and pin table: membrane keypad, Blink keypad, tach, hub
2026-10-18 Speedo alternate data face (Air/Oil/Speed/Volts from Haltech), key 3 tap/hold, 0x6A1 byte 3, bench sim sends 0x361/0x368/0x372
2026-10-18 BOM: owner has one SN65HVD230, needs one more for the bench
2026-10-19 Frame fit check, 3 mm overlay, error alerts + buzzer + check-engine lamp (hub config, tests, wiring, mocks)
    [neon_overlay.stl, neon_overlay_outline.dxf, overlay.scad]
2026-10-19 CEL lamp above the pump at 120 % (fuel + ethanol faces); outlined error flash; buzzer confirmed tone-driven
    [alerts_config.h]
2026-10-19 Frame trim template for the 5in board (flange + surround), decision logged
    [frame_trim.dxf]
2026-10-19 Display brightness/resolution check: 5in backlight is on/off only; calibration task
2026-10-20 Knob demo firmware (standalone, USB) + art export + directions; compiles on esp32 core 3.3.12 / LovyanGFX 1.2.33
2026-10-23 Knob demo: fix hold-invert polarity (LovyanGFX XORs invertDisplay with panel invert=true), screen now returns to normal
    [knob_demo.ino]
2026-10-23 Night mode: park-lamp sense via PC817 on hub GPIO2 (park_lamp.h + test, wiring, BOM, plan); knob demo BOOT day/night with night faces
2026-10-23 Night brightness: dimmer input on hub GPIO1 (dimmer.h + test, wiring + measurement steps, BOM, plan)
2026-10-23 Behaviour specs: selection cue, persistence, knob sleep, startup/shutdown, per-screen peak brightness; plain-text settings file; power latch proposal; CAN 0x6A1/0x6A4
2026-10-26 Gauge display speed: shared needle_render.h (spans, fixed point, dirty spans, internal-RAM art) + host test; tach demo 60 Hz pclk, panel-synced frames, FPS lock 30, timing prints; config + spec
    [needle_render.h, tach_demo.ino]
2026-10-26 Tach demo: silence the 2.8C onboard buzzer (TCA9554 EXIO8 latch powers up high); plan + board-init rule
    [tach_demo.ino]
2026-10-27 Record owner scale check: overlay geometry ~3.5% small (speedo 104.4 vs 101.0 mm, tach 81.5 vs 78.7); x1.035 proposed, not applied; do-not-print warnings
2026-10-27 Scale check: outline confirmed (+0.55%), holes trace ~1.55 mm/side small (edge offset); x1.035 withdrawn; overlay holes screen-limited, unchanged
2026-10-27 Plan: speedo board options with the 2.8C tach (3.4C vs 4.0in P4) for the new overlay
2026-10-27 Speedo 4C feasible: owner OK with frame cut + 10 mm drop; height check confirms scale; 4C specs from Waveshare
2026-10-27 Lock speedo 4C; layout v4 + overlay v4 around the screens (one rounded temp/fuel cutout), frame trim v4
    [frame_trim_v4.dxf, neon_overlay_v4.dxf, neon_overlay_v4.stl]
2026-10-27 BOM: 4C price as listed range
2026-10-27 Tach art maximized (0.877 of stock); 2.8C measured 72.4x76.2 -> tach at stock pivot; 4C top edge confirmed
    [frame_trim_v4.dxf, neon_overlay_v4.dxf, neon_overlay_v4.stl]
2026-10-27 Tach demo: power-on startup GIF (fade in, 9 s, fade out, face fade-up 1 s); custom partition
    [partitions.csv]
2026-10-27 Tach demo startup: GIF cut before the neon card (94 frames), play once, 0.3 s fade, face up 1 s
2026-11-02 Bench wiring: twist knob (CAN board #3) replaces the membrane keypad
    [wiring_diagram.py]
2026-11-05 Breadboard layout for car I/O circuits
